tgolla/AerobicSepticSystemMonitor/BeyondBlink/credentials.h

// Note that this file was created without actual passwords, commited to Git and
// then set to be excluded from being checked from future changes with the following command.
//
//   git update-index --assume-unchanged credentials.h           
//
// https://arduino.stackexchange.com/questions/40411/hiding-wlan-password-when-pushing-to-github/55583#55583

#ifndef CREDENTIALS_H
#define CREDENTIALS_H

// Replace with your actual SSID and password:
#define WIFI_SSID "Your WiFI SSID here"
#define WIFI_PASSWORD "Your WiFi password here"

#endif
