tgolla/AerobicSepticSystemMonitor/(commit log)

2024-02-10 Corrected serial message in beyond blink.
    [BeyondBlink.ino]
2024-02-11 Documenting Is the Power On (220V Optocoupler Module).
2024-03-23 Is the power on testing code.
2024-03-23 Updated is the power on documentation. Need circuit drawing.
2024-03-23 Finished Is the Power On documentation.
2024-03-25 Half way through Is the Pump Running documentation.
2024-03-26 Updated to 20A current sensor.
2024-03-27 Completed Is the Pump Running (Current Sensor) beta testing documentation.
